TomasChovanec/Arduino_robotek/FrenGP_robot/FrenGP_robot.png

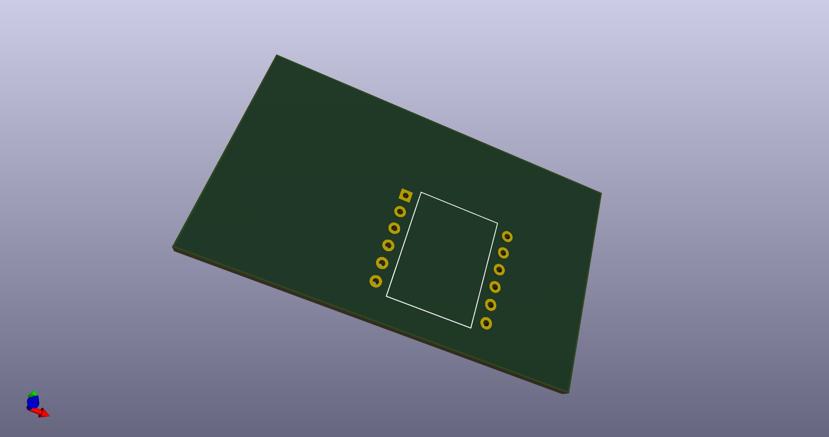
FrenGP_robot/FrenGP_robot.png
