TomasChovanec/Arduino_robotek/FrenGP_robot/Navod_sestaveni.pptx

## Fren ROBOT V1.0

## Vložte 2ks matka M3n

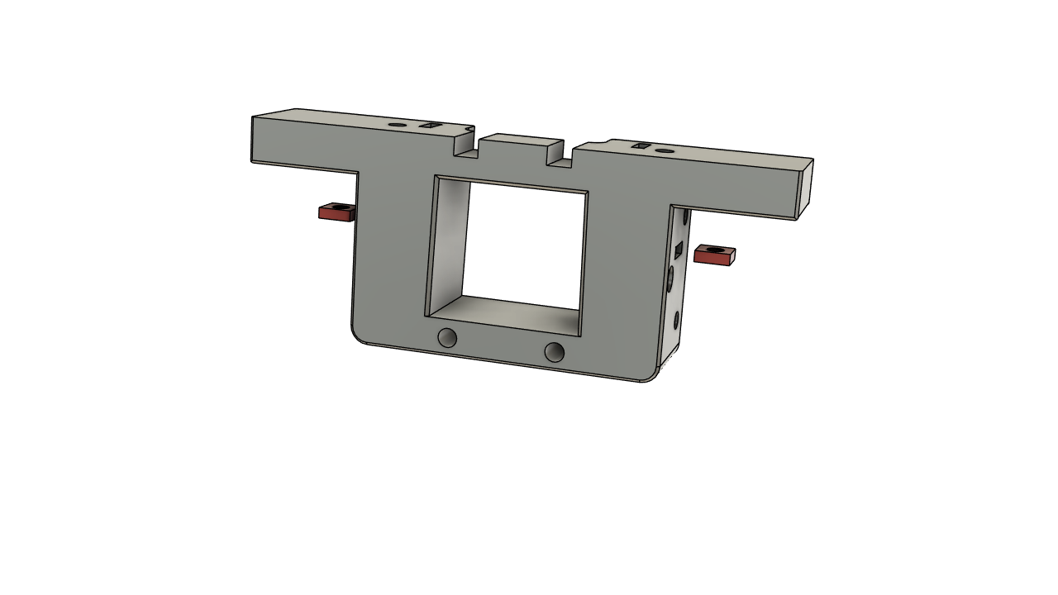
[picture p2: figure]

## Vložte 4ks matka M3n

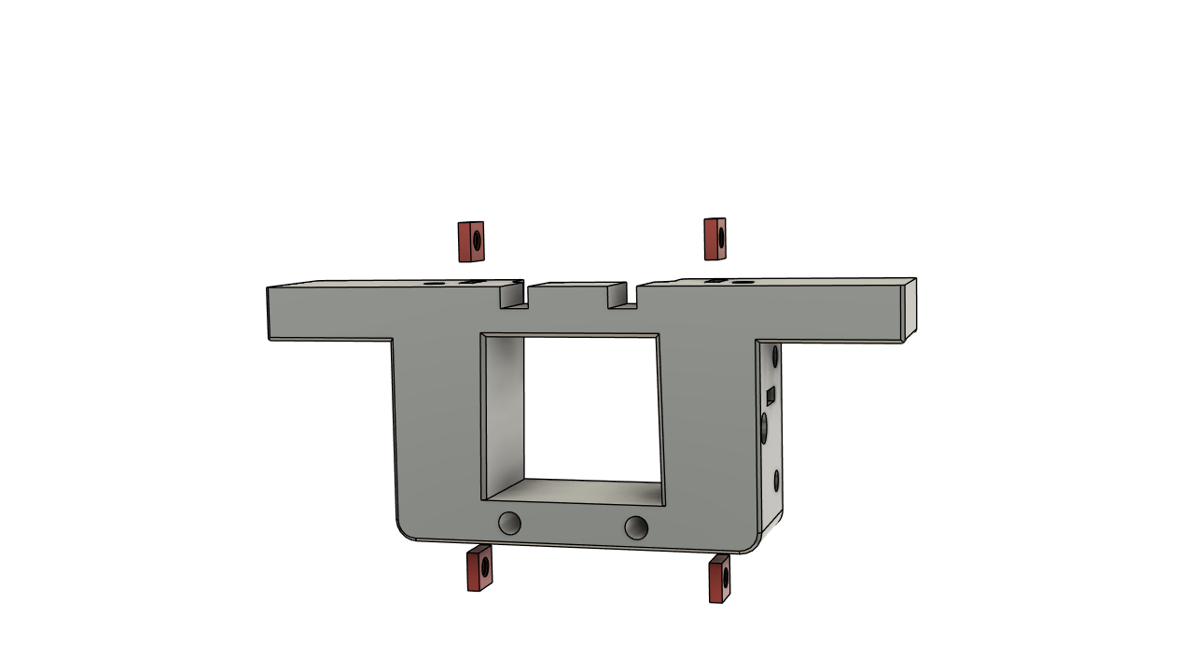
[picture p3: figure]

## Zašroubujte 4ks M3x30

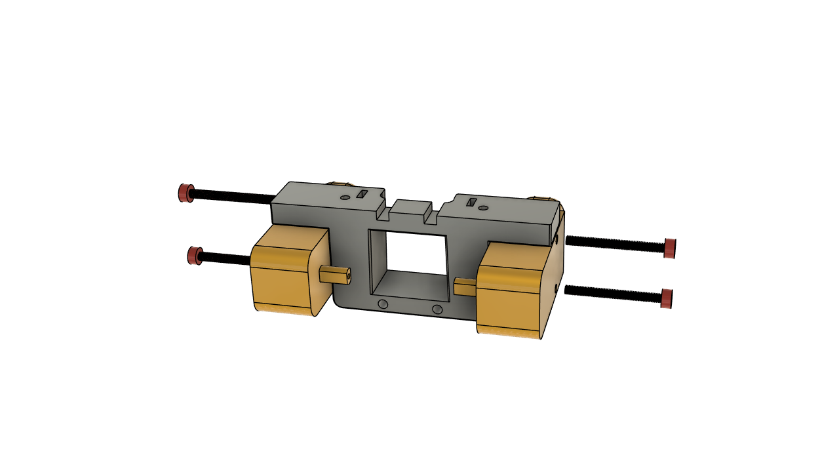
[picture p4: figure]

## Vložte 4ks matka M3n

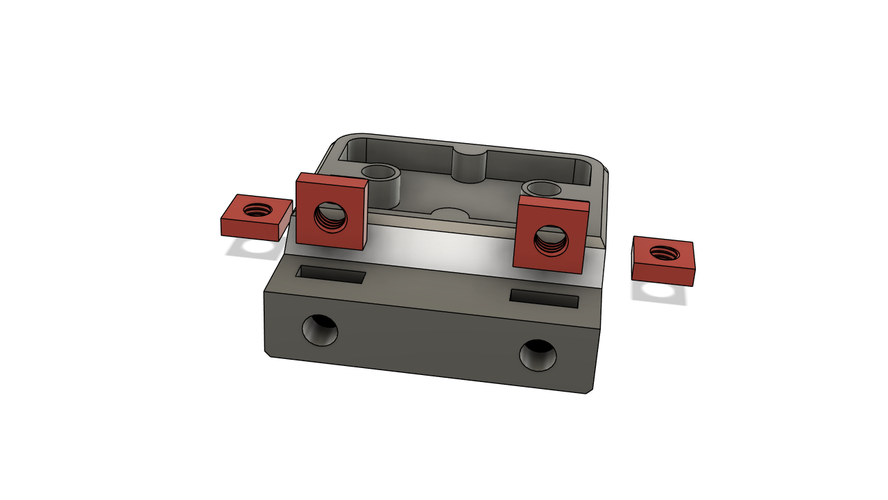
[picture p5: figure]

## Zašroubujte 2ks M3x25

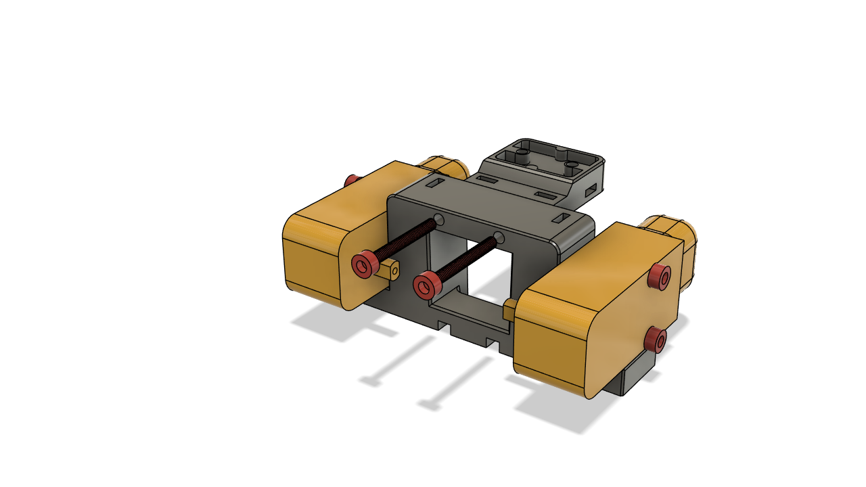
[picture p6: figure]

## Vložte silon s kuličkou (není na obrázku) Zašroubujte 2x M3x8

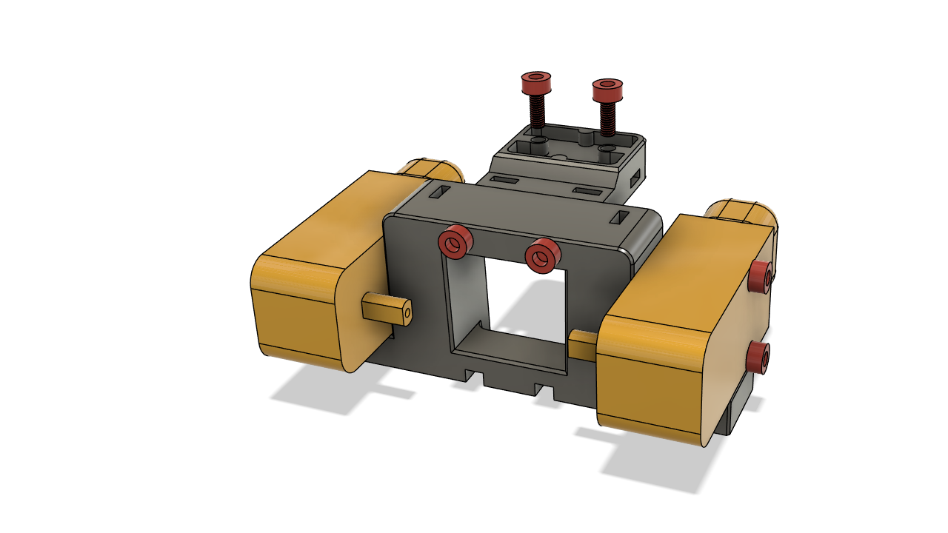
[picture p7: figure]

## Zašroubujte M3x20

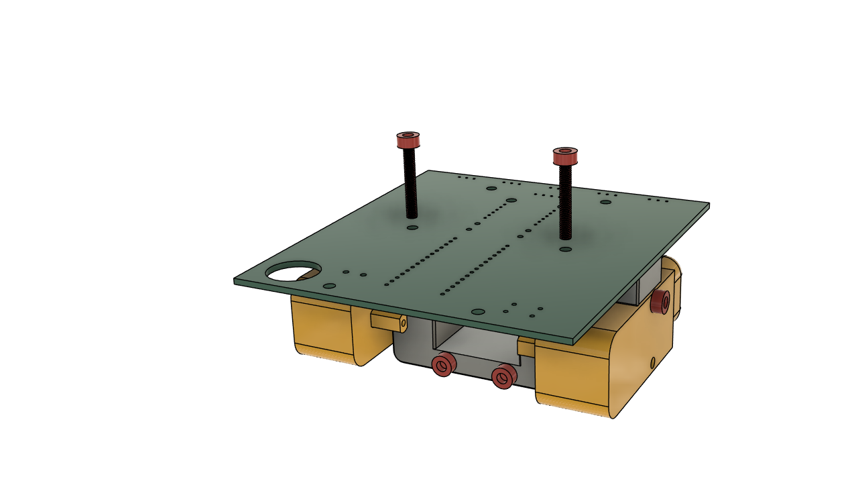
[picture p8: figure]

## Vložte 2ks M3n

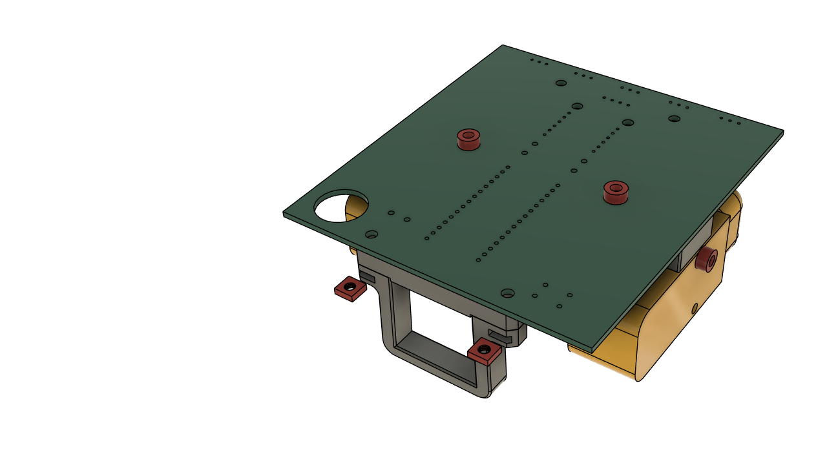
[picture p9: figure]

## Zašroubujte 2ks M3x14

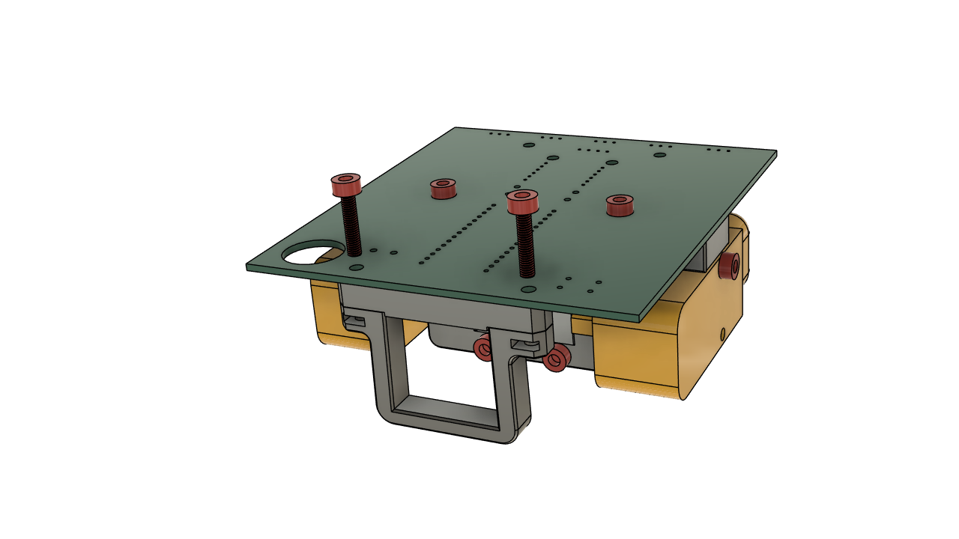
[picture p10: figure]

## Vložte 2ks M3n

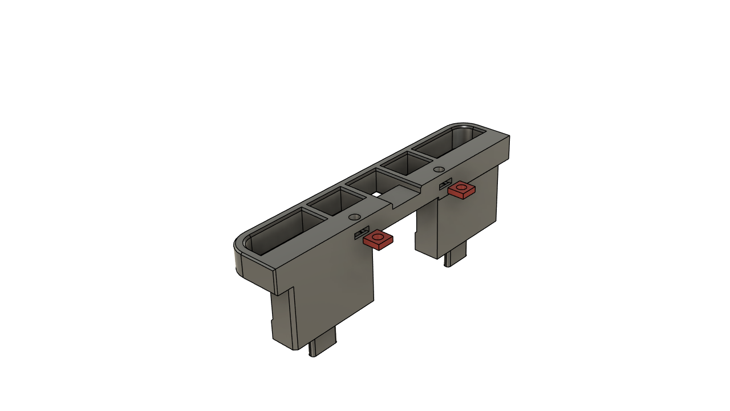
[picture p11: figure]

## Zašroubujte 2ks M3x6

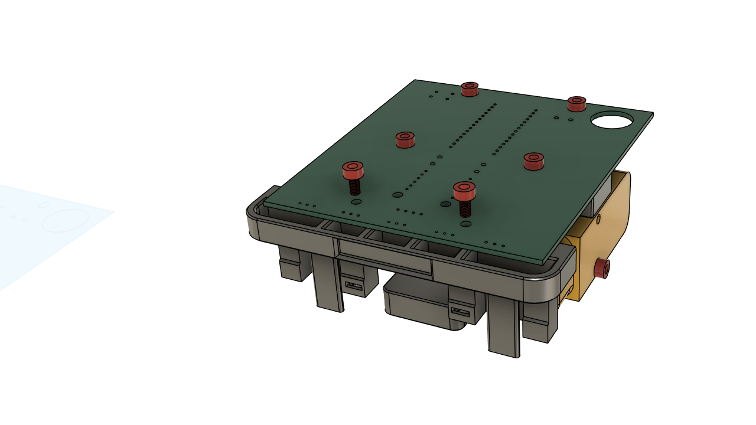
[picture p12: figure]

## Vložte 2ks M3n

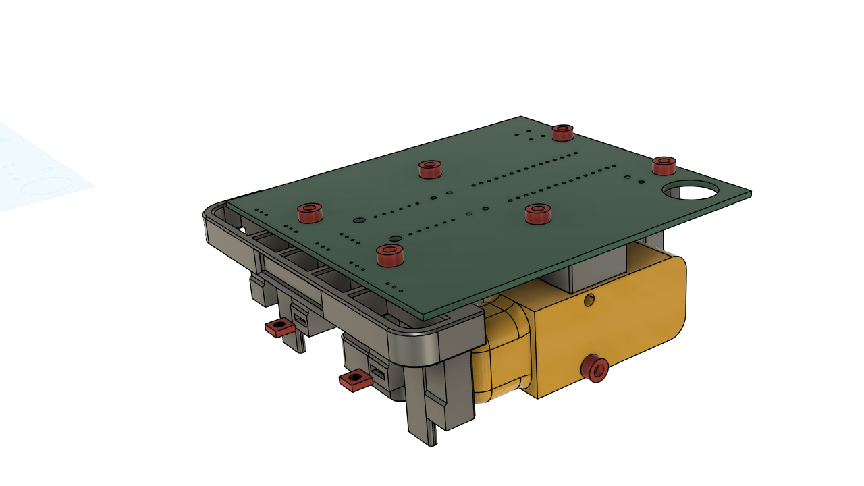
[picture p13: figure]

## Vlože na strany pružiny (nejsou na obrázku) Vložte desku s IR čidly a zašroubujte 2ks M3x30

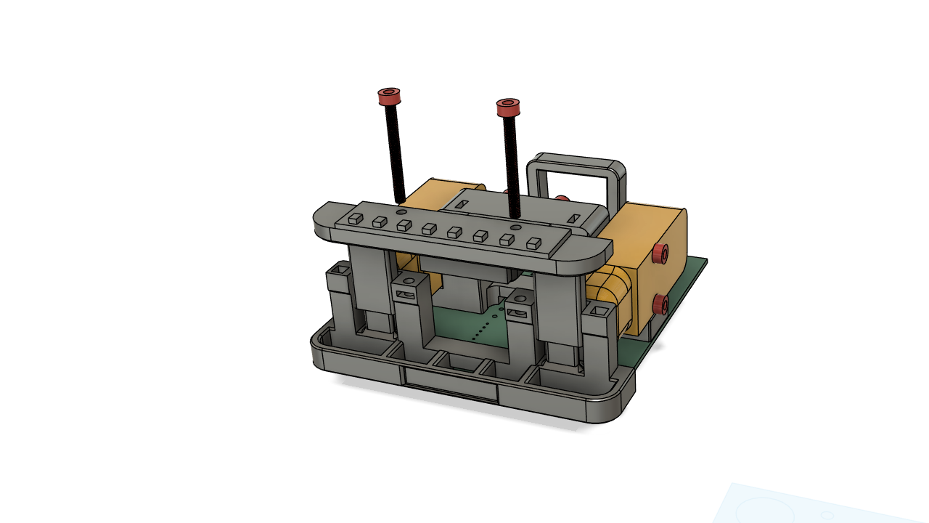
[picture p14: figure]
