TomasChovanec/Arduino_robotek/FrenGP_robot/FrenGP_robot.step

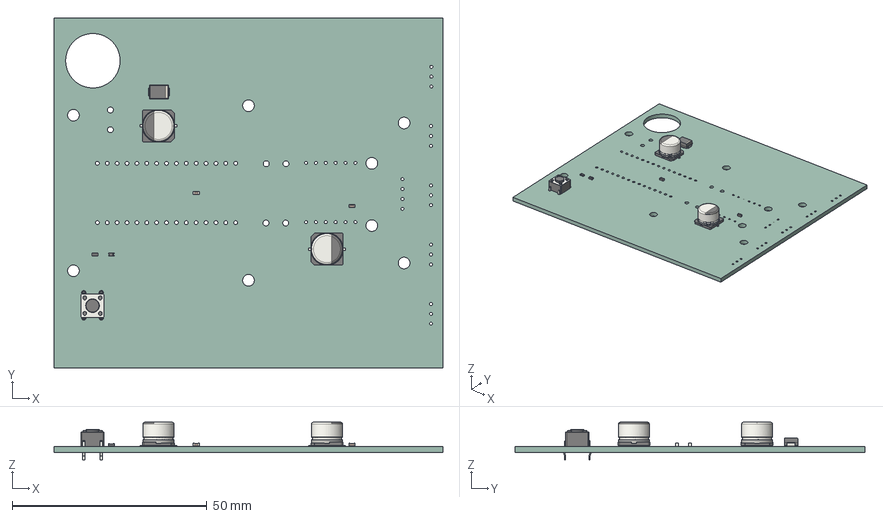
[picture p15: CAD file, 2024-09-28]
FrenGP_robot/FrenGP_robot.step
100.0 x 90.0 x 9.70 mm
R_0603_1608Metric
CP_Elec_8x62 x 2
D_SMB
SW_PUSH_6mm
C_0603_1608Metric x 2
D_0603
_autosave-FrenGP_robot_PCB
