TomasChovanec/Arduino_robotek/FrenGP_robot/FrenGP_robot.kicad_pcb

## KiCad design FrenGP_robot/FrenGP_robot.kicad_pcb (2025-10-01)

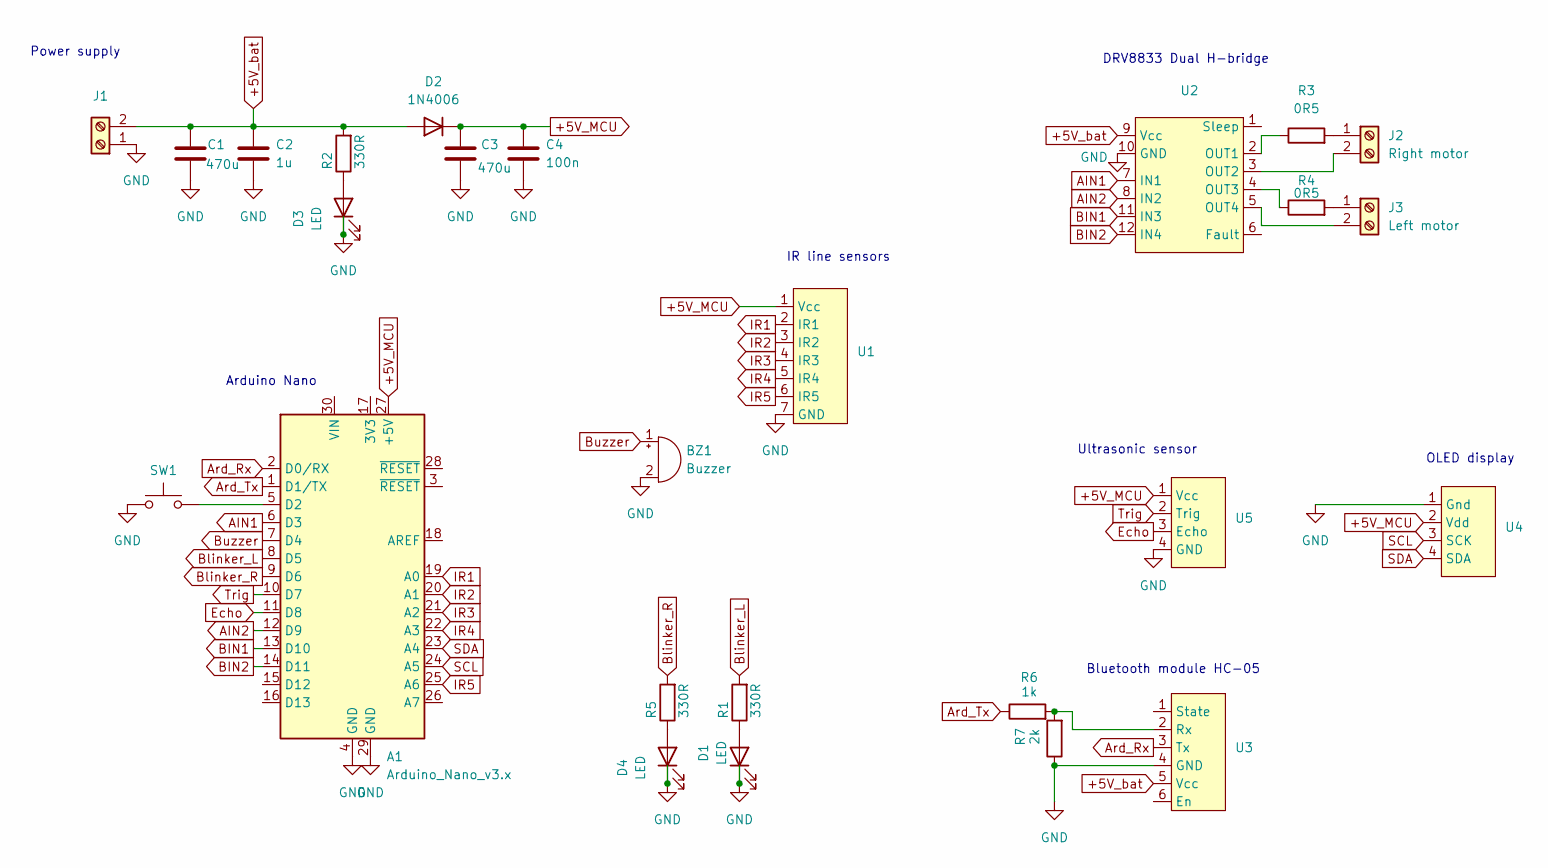
[picture p16: schematic FrenGP_robot.kicad_sch]

Parts:
A1: Arduino_Nano_v3.x; Arduino_Nano
BZ1: Buzzer; Buzzer_12x9.5RM7.6
C1, C3: 470u; CP_Elec_8x6.2
C2: 1u; C_0603_1608Metric_Pad1.08x0.95mm_HandSolder
C4: 100n; C_0603_1608Metric_Pad1.08x0.95mm_HandSolder
D1, D3, D4: LED; D_0603_1608Metric_Pad1.05x0.95mm_HandSolder
D2: 1N4006; D_SMA-SMB_Universal_Handsoldering
J1: Screw_Terminal_01x02; TerminalBlock_bornier-2_P5.08mm
J2: Right motor; TerminalBlock_bornier-2_P5.08mm
J3: Left motor; TerminalBlock_bornier-2_P5.08mm
R1, R2, R5: 330R; R_0603_1608Metric_Pad0.98x0.95mm_HandSolder
R3, R4: 0R5; R_0805_2012Metric_Pad1.20x1.40mm_HandSolder
R6: 1k; R_0603_1608Metric_Pad0.98x0.95mm_HandSolder
R7: 2k; R_0603_1608Metric_Pad0.98x0.95mm_HandSolder
SW1: SW_Push; SW_PUSH_6mm
U1: IR sensor header
U2: DIP-12_W15.24mm
U3: HC-05 header
U4: OLED display header
U5: HC-SR04_module

Connections:
+5V_MCU: A1.27 (+5V), C3.1, C4.1, D2.1 (K), U1.1 (Vcc), U4.2 (Vdd), U5.1 (Vcc)
+5V_bat: C1.1, C2.1, D2.2 (A), J1.2, R2.2, U2.9 (Vcc), U3.5 (Vcc)
AIN1: A1.6 (D3), U2.7 (IN1)
AIN2: A1.12 (D9), U2.8 (IN2)
Ard_Rx: A1.2 (D0/RX), U3.3 (Tx)
Ard_Tx: A1.1 (D1/TX), R6.1
BIN1: A1.13 (D10), U2.11 (IN3)
BIN2: A1.14 (D11), U2.12 (IN4)
Blinker_L: A1.8 (D5), R1.2
Blinker_R: A1.9 (D6), R5.2
Buzzer: A1.7 (D4), BZ1.1 (+)
Echo: A1.11 (D8), U5.3 (Echo)
GND: A1.4 (GND), A1.29 (GND), BZ1.2 (-), C1.2, C2.2, C3.2, C4.2, D1.1 (K), D3.1 (K), D4.1 (K), J1.1, R7.1, SW1.1, U1.7 (GND), U2.10 (GND), U3.4 (GND), U4.1 (Gnd), U5.4 (GND)
IR1: A1.19 (A0), U1.2 (IR1)
IR2: A1.20 (A1), U1.3 (IR2)
IR3: A1.21 (A2), U1.4 (IR3)
IR4: A1.22 (A3), U1.5 (IR4)
IR5: A1.25 (A6), U1.6 (IR5)
unnamed: A1.5 (D2), SW1.2
unnamed: D1.2 (A), R1.1
unnamed: D3.2 (A), R2.1
unnamed: D4.2 (A), R5.1
unnamed: J2.1, R3.2
unnamed: J2.2, U2.3 (OUT2)
unnamed: J3.1, R4.2
unnamed: J3.2, U2.5 (OUT4)
unnamed: R3.1, U2.2 (OUT1)
unnamed: R4.1, U2.4 (OUT3)
unnamed: R6.2, R7.2, U3.2 (Rx)
SCL: A1.24 (A5), U4.3 (SCK)
SDA: A1.23 (A4), U4.4 (SDA)
Trig: A1.10 (D7), U5.2 (Trig)

Notes on the sheet:
Power supply
Bluetooth module HC-05
Ultrasonic sensor
Arduino Nano
IR line sensors
OLED display
DRV8833 Dual H-bridge

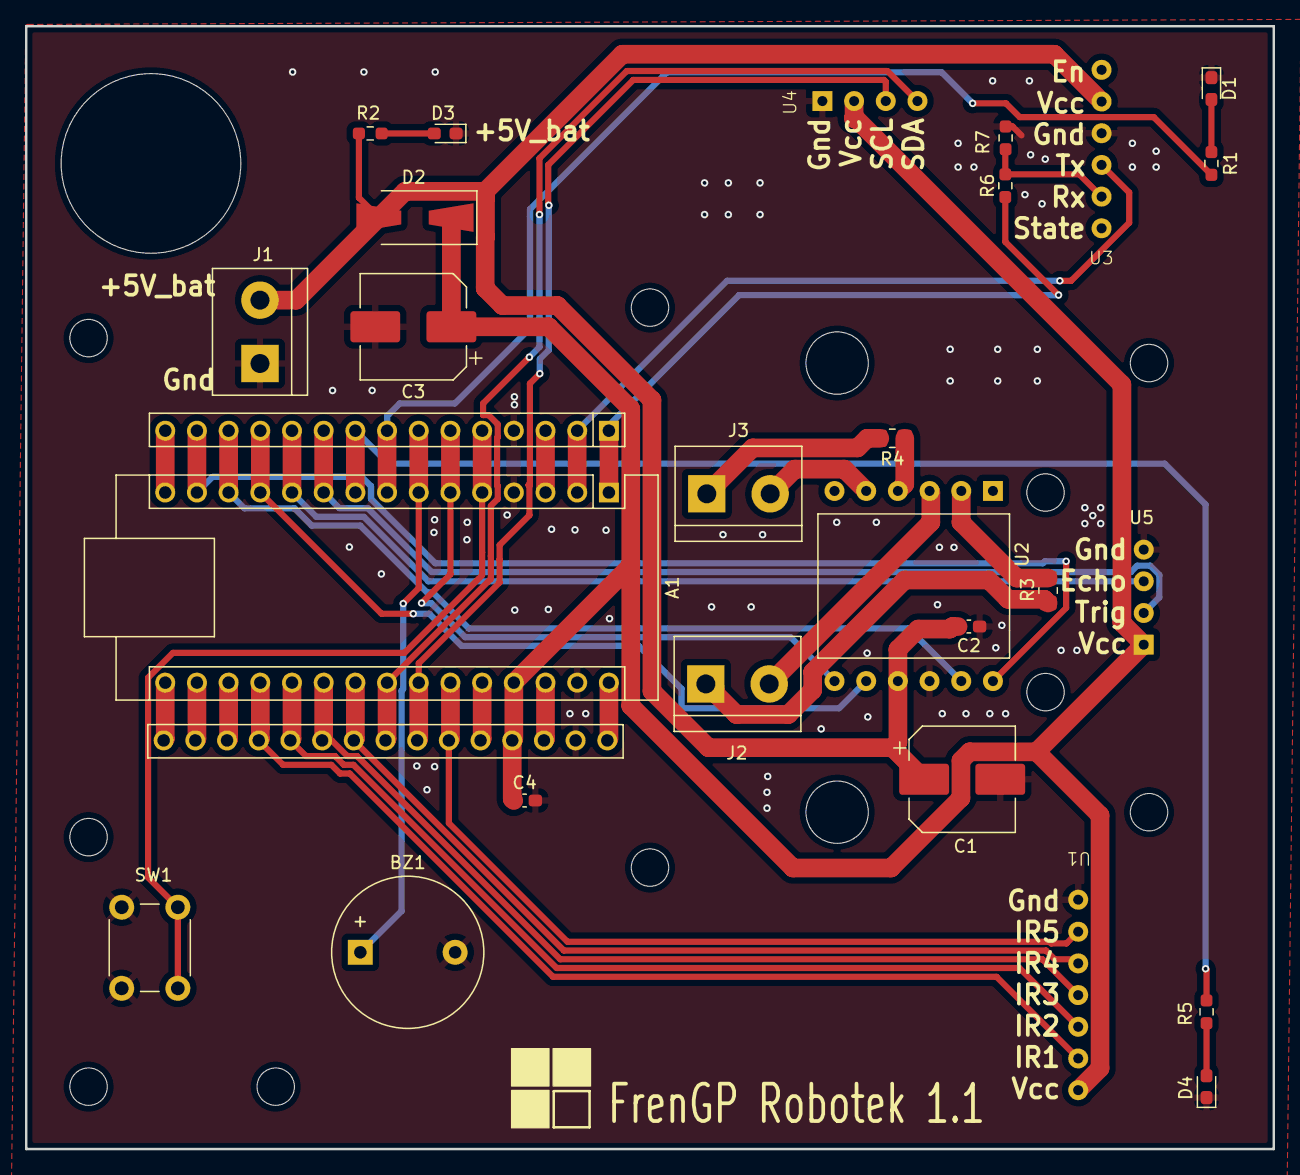
[picture p17: board FrenGP_robot.kicad_pcb from above]

Board: 2 copper layers, 100.0 x 90.0 mm, 26 parts (0 on the bottom side), 32 nets.
