TomasChovanec/Arduino_robotek/(commit log)

2024-09-28 Gerbers added
    [FrenGP_robot-B_Cu.gbr, FrenGP_robot-B_Mask.gbr, FrenGP_robot-B_Paste.gbr, FrenGP_robot-B_Silkscreen.gbr, FrenGP_robot-Edge_Cuts.gbr, FrenGP_robot-F_Cu.gbr, FrenGP_robot-F_Mask.gbr, FrenGP_robot-F_Paste.gbr]
2024-09-28 Release folder created
    [FrenGP_robot-B_Cu.gbr, FrenGP_robot-B_Mask.gbr, FrenGP_robot-B_Paste.gbr, FrenGP_robot-B_Silkscreen.gbr, FrenGP_robot-Edge_Cuts.gbr, FrenGP_robot-F_Cu.gbr, FrenGP_robot-F_Mask.gbr, FrenGP_robot-F_Paste.gbr]
2025-10-01 Assembly manual added
